poulet-lab/Bpod_USB_Host/README.md

# Bpod USB Host

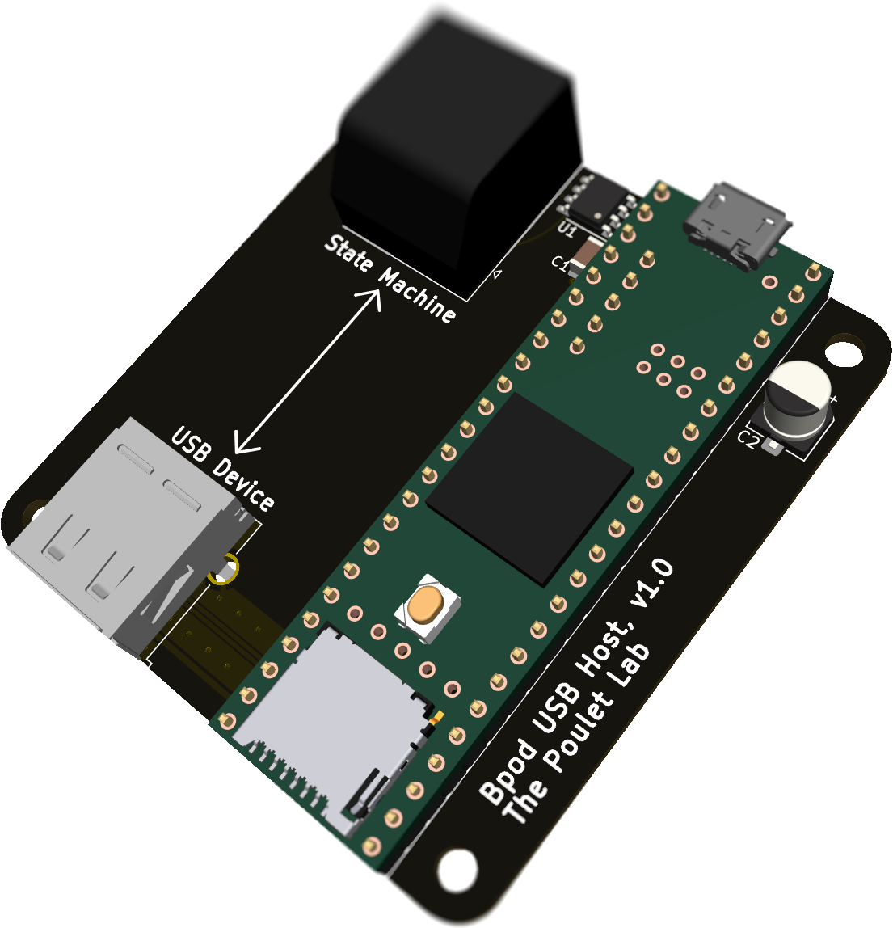
[picture p1: PCB/v1.0/Bpod_USBhost_R1.png]

Connect USB devices like a keyboard, mouse or gamepad to the Bpod State Machine
