poulet-lab/Bpod_USB_Host/PCB/v1.0/Bpod_USBhost_R1_tmp.png

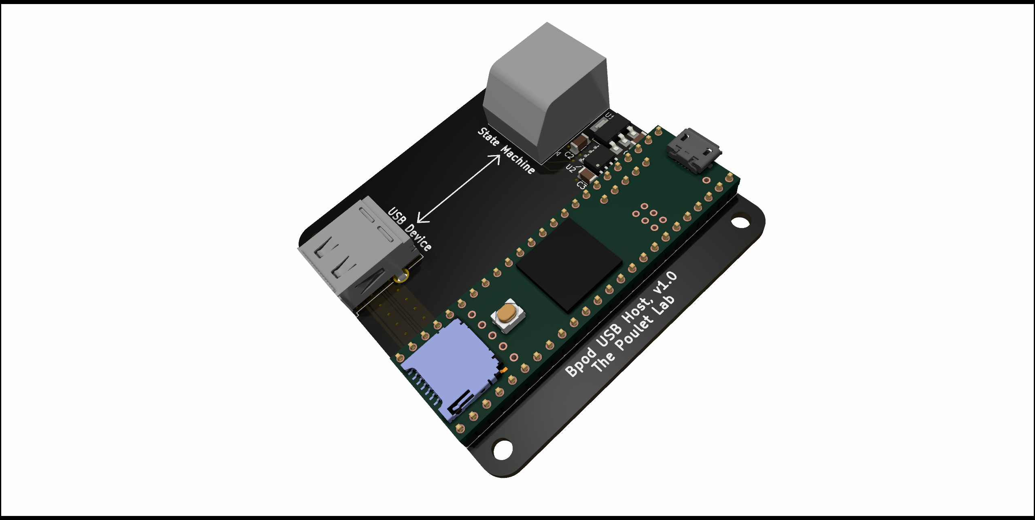
PCB/v1.0/Bpod_USBhost_R1_tmp.png
