poulet-lab/Bpod_USB_Host/(commit log)

2023-02-14 PCB v1.0
    [Bpod_USBhost_R1.kicad_pcb, Bpod_USBhost_R1.kicad_sch]
2023-02-14 fixing some mistakes / adding render
    [Bpod_USBhost_R1.kicad_pcb]
2023-02-15 differential pair routing for D+/D-
    [Bpod_USBhost_R1.kicad_pcb]
2023-02-15 fixed differential pair routing
    [Bpod_USBhost_R1.kicad_pcb]
2023-02-15 fix silkscreen
    [Bpod_USBhost_R1.kicad_pcb]
2023-02-15 add partial ground fill to front
    [Bpod_USBhost_R1.kicad_pcb]
2023-02-15 some GND vias to stich the two ground planes
    [Bpod_USBhost_R1.kicad_pcb]
2023-02-16 impedance optimization + denser via fence
    [Bpod_USBhost_R1.kicad_pcb, Bpod_USBhost_R1.kicad_sch]
2023-02-16 minor fix for silk screen / board dimensions
    [Bpod_USBhost_R1.kicad_pcb]
2023-02-20 minor fix to 5V plane and GND vias
    [Bpod_USBhost_R1.kicad_pcb]
2023-02-21 removed power through FSM, added capacitor for 3.3V
    [Bpod_USBhost_R1.kicad_pcb, Bpod_USBhost_R1.kicad_sch]
2023-02-21 minor clean-up
    [Bpod_USBhost_R1.kicad_pcb, Bpod_USBhost_R1.kicad_sch]
