poulet-lab/Bpod_USB_Host/(notices)

Notices in the files:
src/Bpod_USBhost.cpp:
This program is free software: you can redistribute it and/or modify it under
the terms of the GNU General Public License as published by the Free Software
